rudiger7/pizpast-keyboard/hardware/layout/plate.dxf

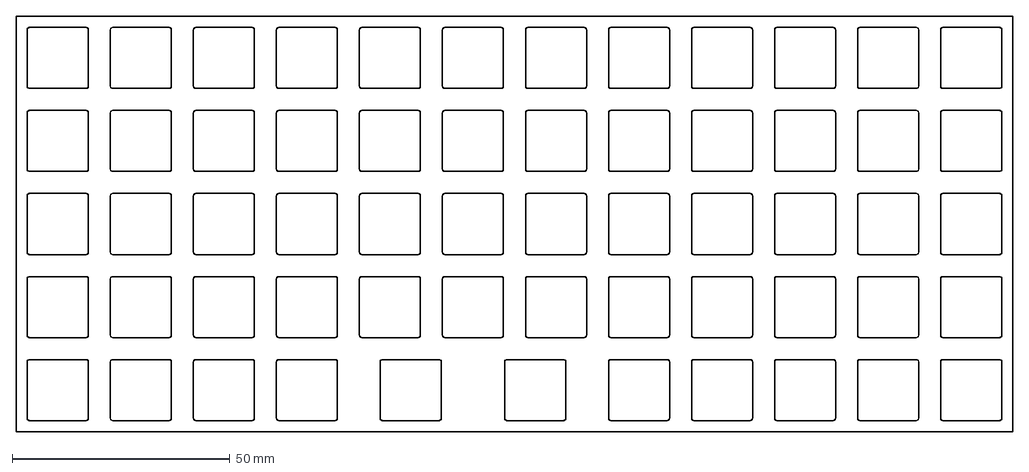
[picture p1: CAD file, 2026-11-10]
hardware/layout/plate.dxf
228.6 x 95.2 mm
