rudiger7/pizpast-keyboard/case/legacy-fusion/support1.stl

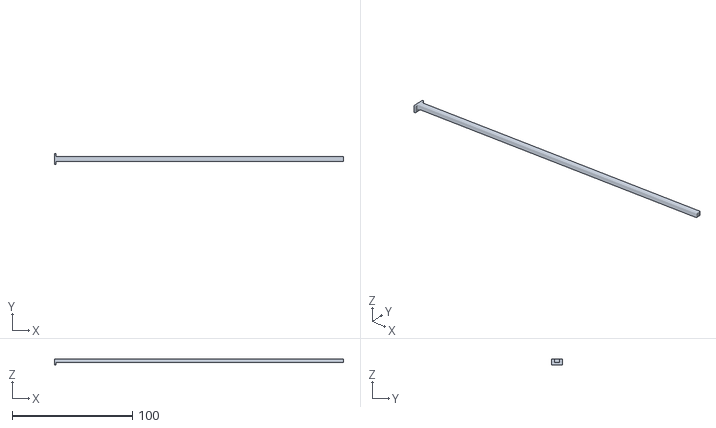
[picture p2: CAD file, 2026-11-10, an earlier design]
case/legacy-fusion/support1.stl
240.6 x 9.10 x 5.20
