rudiger7/pizpast-keyboard/keycaps/legacy/legends/W.stl

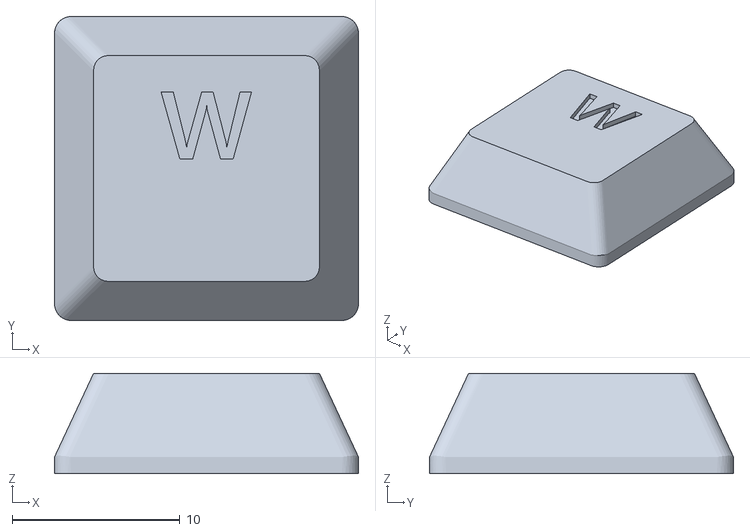
[picture p3: CAD file, 2026-11-10, an earlier design]
keycaps/legacy/legends/W.stl
18.1 x 18.2 x 6.00
