rudiger7/pizpast-keyboard/keycaps/legacy/lowest_keycap_1x1.00 v14.3mf

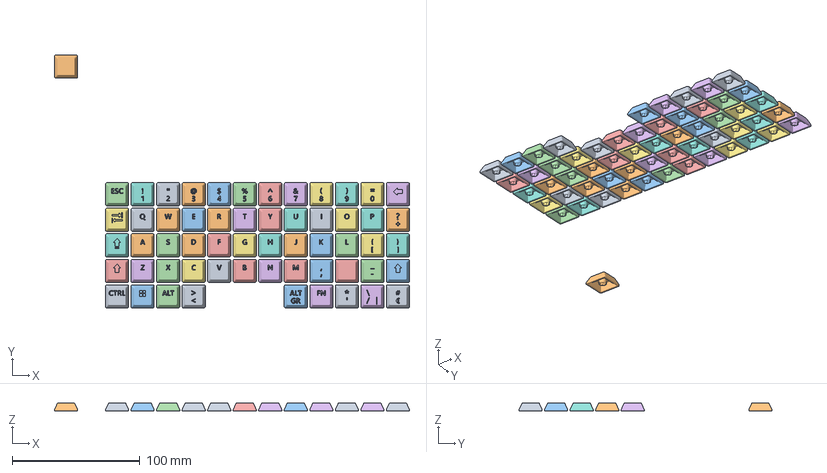
[picture p4: CAD file, 2026-11-10, an earlier design]
keycaps/legacy/lowest_keycap_1x1.00 v14.3mf
278.1 x 198.2 x 6.00 mm
'
+
,
/
<
A
ALT GR
ALT
B
BACK
C
CAPS
CTRL
D
E
ESC
F
FN
G
H
I
J
K
L
M
N
O
P
Q
R
RIGHT SHIFT
S
SHIFT
T
TAB
U
V
W
WIN
X
Y
Z
[
]
eur
key
