rudiger7/pizpast-keyboard/case/legacy-fusion/Body20.stl

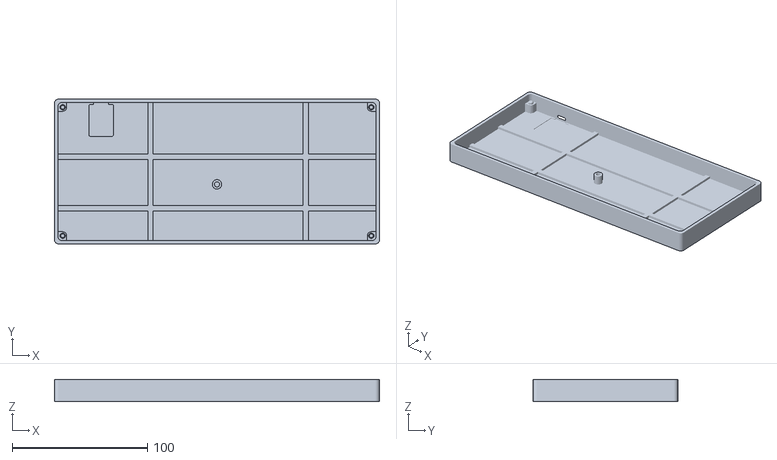
[picture p5: CAD file, 2026-11-10, an earlier design]
case/legacy-fusion/Body20.stl
240.6 x 107.3 x 16.6
