rudiger7/pizpast-keyboard/case/legacy-fusion/base.stl

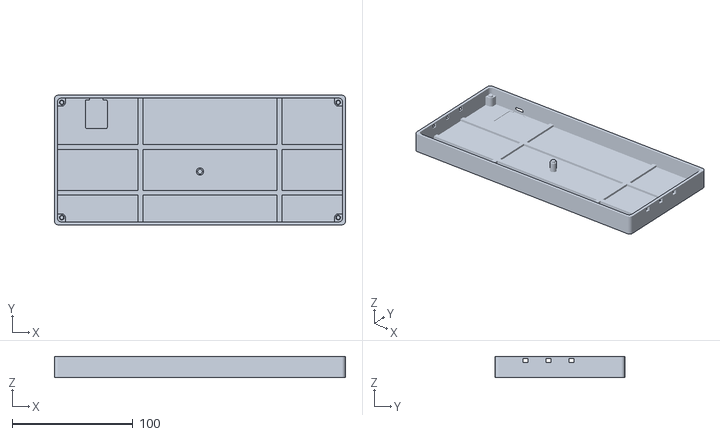
[picture p6: CAD file, 2026-11-10, an earlier design]
case/legacy-fusion/base.stl
240.6 x 107.3 x 17.6
