rudiger7/pizpast-keyboard/keycaps/legacy/lowest_keycap_1x1.50.stl

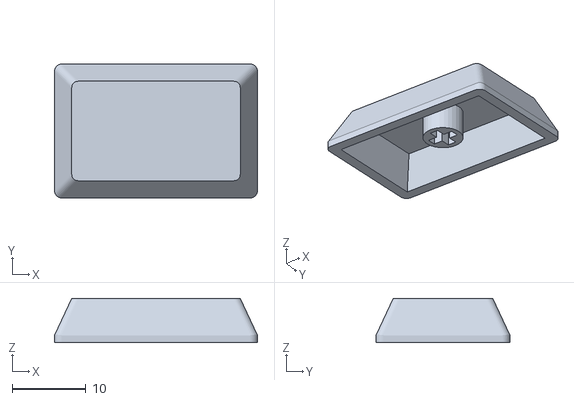
[picture p7: CAD file, 2026-11-10, an earlier design]
keycaps/legacy/lowest_keycap_1x1.50.stl
27.5 x 18.1 x 6.00
