rudiger7/pizpast-keyboard/case/legacy-fusion/plate.stl

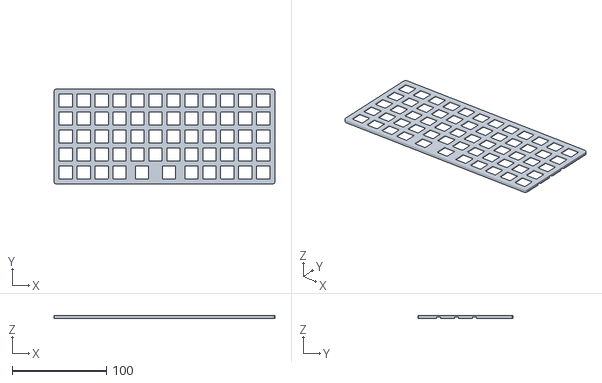
[picture p8: CAD file, 2026-11-10, an earlier design]
case/legacy-fusion/plate.stl
234.5 x 101.2 x 3.00
