rudiger7/pizpast-keyboard/(list of files, cad)

Other CAD files:
keycaps/legacy/legends/R.stl
keycaps/legacy/lowest_keycap_1x1.00.stl
keycaps/legacy/legends/T.stl
keycaps/legacy/legends/E.stl
keycaps/legacy/legends/Y.stl
keycaps/legacy/legends/Q.stl
